Zighhi/Preamp-with-Tone-Control/P1_435B_Zglimbea_Andrei.pdf

Universitatea POLITEHNICA
București Facultatea E.T.T.I. Anul universitar 2022-2023

# PROIECT 1

## Proiectarea și realizarea unui preamplificator audio cu corectie de ton

N = 2

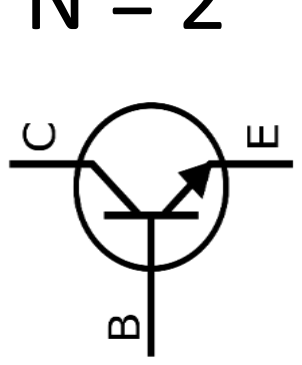
[picture p1: figure]

Coordonator științific: | Zglimbea Andrei
Prof. dr. ing. Dragoș Dobrescu | Grupa 435 B

## CUPRINS

2.Date initiale de

3.Simulari |
4.Asamblare |

5.Manual de

6.Bibliografia |

## 1.INTRODUCERE

### 1.1 Amplificatorul audio

Un amplificator audio este utilizat pentru a creste amplitudinea unei forme de undă a semnalului,fără a modifica alți parametrii ai formei de undă,cum ar fi frecventa sau forma de undă.Ele sunt unul dintre cele mai frecvent utilizate circuite in electronică și îndeplinesc o varietate de funcții într-un număr mare de sisteme electronica.

Amplificatoarele de tensiune audio sunt folosite pentru a amplifica semnalele de nivel scăzut de la microfoane,pickup-uri de bandă si disc.Cu circuite suplimentare,ele indeplinesc funcții precum corecția tonului,egalizarea nivelurilor de semnal si mixarea de la diferite intrări,in general au caștig de tensiune ridicat ,si mediu pana la rezistena ridicata de iesire.

Rolul unui amplificator audio este: de a mari semnalul sonor de intrare,de a reda un volum mai puternic.Iar aceste lucruri sunt posibile prin intermediul sistemului de boxe conectat la sursa de amplificare.Semnalul audio preluat de amplificator din dispozitive de receptie,precum instrumentele muzicale,laptopurile,casetofoanele, este de slaba putere.Circuitul de iesire din componenta amplificatorului este cel care,dupa ce preia acest semnal slab,genereaza unul nou,mai puternic de aceasta data,care ajunge ulterior sa fie redat prin intermediul boxelor.Boxele sunt un element intermediar al sunetului,reusind sa ofere acea calitate despre care vorbim.

### 1.2 Corectorul de ton de tip Baxandall

Circuitul de control al tonului Baxandall este un circuit analogic care asigura controlul independent al frecventelor joase si inalte,atat bass,cat si treble pot fi amplificate sau atenuate ,iar cu ambii parametrii in pozitiile lor medii,ofera un raspund de frecventa relativ plat.

In amplificatoarele hi-fi,controlul tonului se refera la cresterea sau reducerea anumitor frecvente audio,Aceste lucru se poate face pentru a se potrivi preferintelor ascultatorului,nu toata lumea percepe sunetul exact in acelasi mod,de exemplu raspunsul in frecventa al urecii umane se modifica odata cu varsta.Camera sau sala in care este reprodus sunetul va afecta,de asemenea,natura sunetului.Multe tehnici sunt folosite pentru a modifica sunetul,si in special raspunsul in frecventa al amplificatoarelor care produc sunetul.Acestea variaza de la simple filtre RC,la retele de control al frecventei pasive si active pana la procesarea complexa a semnalului digital.

## 2.DATE INITIALE DE PROIECTARE

### 2.1 Descrierea proiectului

Să se proiecteze şi să se realizeze practic un preamplificator de audiofrecvență cu corecție de ton având următoarele caracteristici:

- Tensiunea de alimentare unipolară (VCC=12 Volți) sau bipolară (VCC=12 , VEE=-VCC). Semnalizarea prezenței tensiunii cu LED.
- Tensiune de intrare alternativă cu amplitudinea 10 mV.
- Banda de frecvență cuprinsă între fj=200 Hz și fs=6 kHz.
- Frecvența centrală neutră la corecția de ton 2 kHz.
- Corecție de ton de tip BAXANDALL sau echivalentă cu +- (12) dB.
- Amplificarea în tensiune la frecvența neutră 100, echivalentă 40 dB.
- Rezistența de ieșire pentru a utiliza rezistența de sarcină a unor căști de 600 Ohmi.

### 2.2 Schema bloc a montajului electric

Montajul este compus din 4 etaje de amplificare,respectiv unul de intrare si trei de iesire,cuplate prin intermediul retelei de reactie de tip RC.

### 2.3 Schema de principiu propusa a amplificatorului

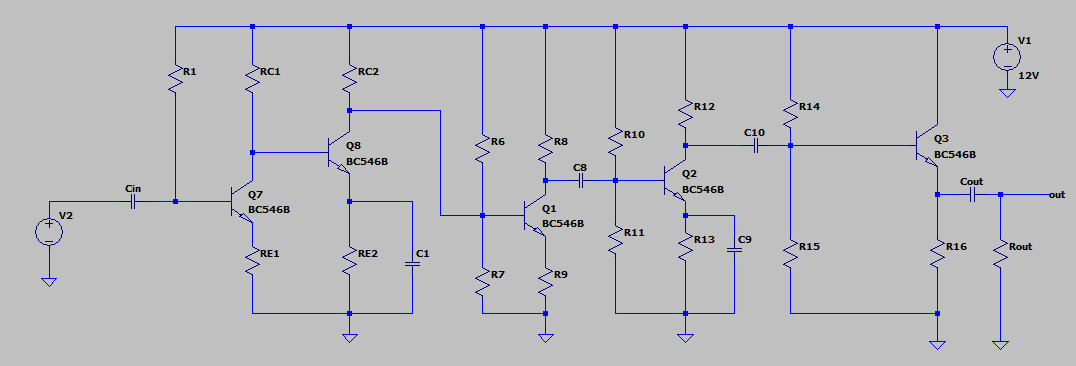
[picture p2: figure]

Amplificatorul este compus din 4 etaje de amplificare:

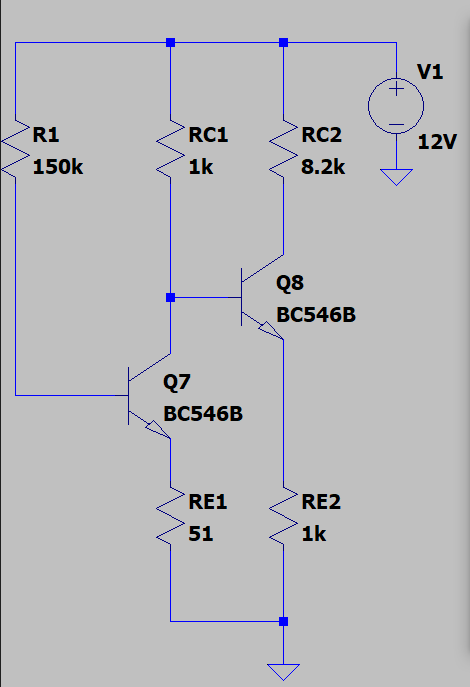
[picture p3: figure]

Etajul de intrare:

Acesta are rolul de combate atenuarea introdusa de corectorul de ton,astfel avand un castig de aproximativ 20 dB.

Etajele de amplificare:

Cel de al doilea si al treilea etaj rolul de a amplifica semnalul

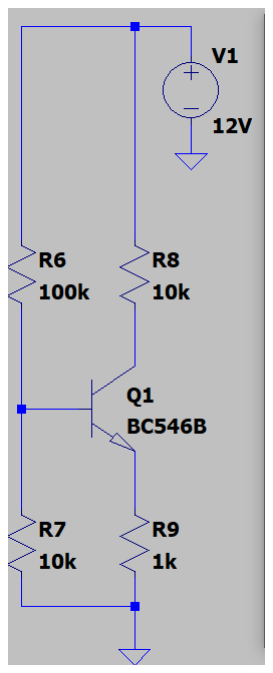
[picture p4: figure]
Aceste doua
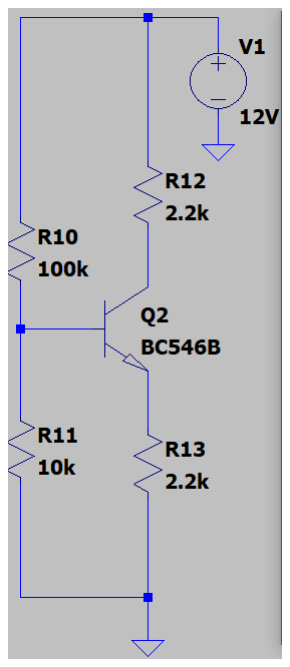
[picture p5: figure]

audio | cu 40 dB,acestea fiind in configuratia emitor comun.Acest tip de
| etaj introduce un defazaj de 90° , astfel prin folosirea a doua astfel
| de etaje semnalul de la iesire va fii in faza cu cel de la intrare.

Etajul de iesire:

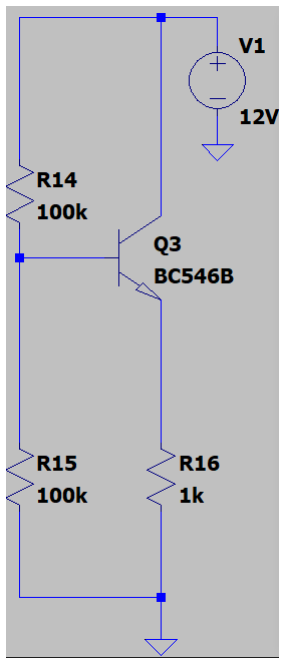
[picture p6: figure]

Etajul de iesire este un colector comun , si acesta are rolul de a mentine amplificarea constanta la 40 dB indiferent de care este sarcina acestui preamplificator.

### 2.4 Corectorul de ton de tip Baxandall

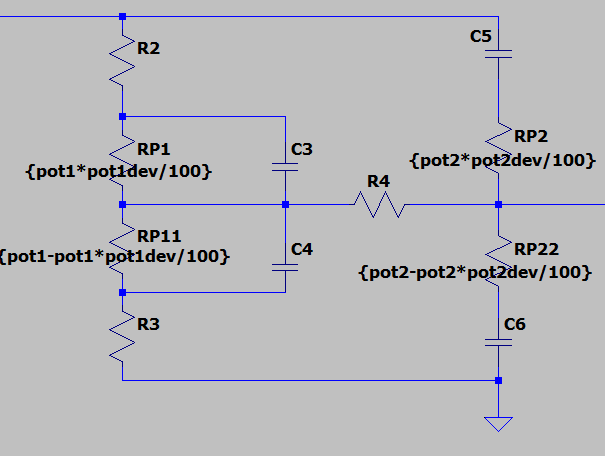
[picture p7: figure]

### 2.5 Dimensionarea componentelor corectorului de ton

RP1 se afla la maxim , deci amplifica frecventele joase fj = 200 Hz.

R2 , C4 formeaza un FTJ ft = 1/2π R2C4 , rezulta R2 = 15 kΩ si C4 = 10 nF.

RP1 la minim , deci atenueaza frecventele joase fj = 200 Hz.

R3 , C3 formeaza un FTS ft = 1/2π R3C3 , rezulta R3 = 1.5 kΩ si C3 = 1 nF.

RP2 la maxim , deci amplifica frecventele inalte fs =6 kHz.

RP2 la maxim , deci atenueaza frecventele inalte fs =6 kHz.

R4 , C6 formeaza un FTJ ft = 1/2π R4C6 , rezulta R4 = 22 kΩ si C6 = 4.7 nF

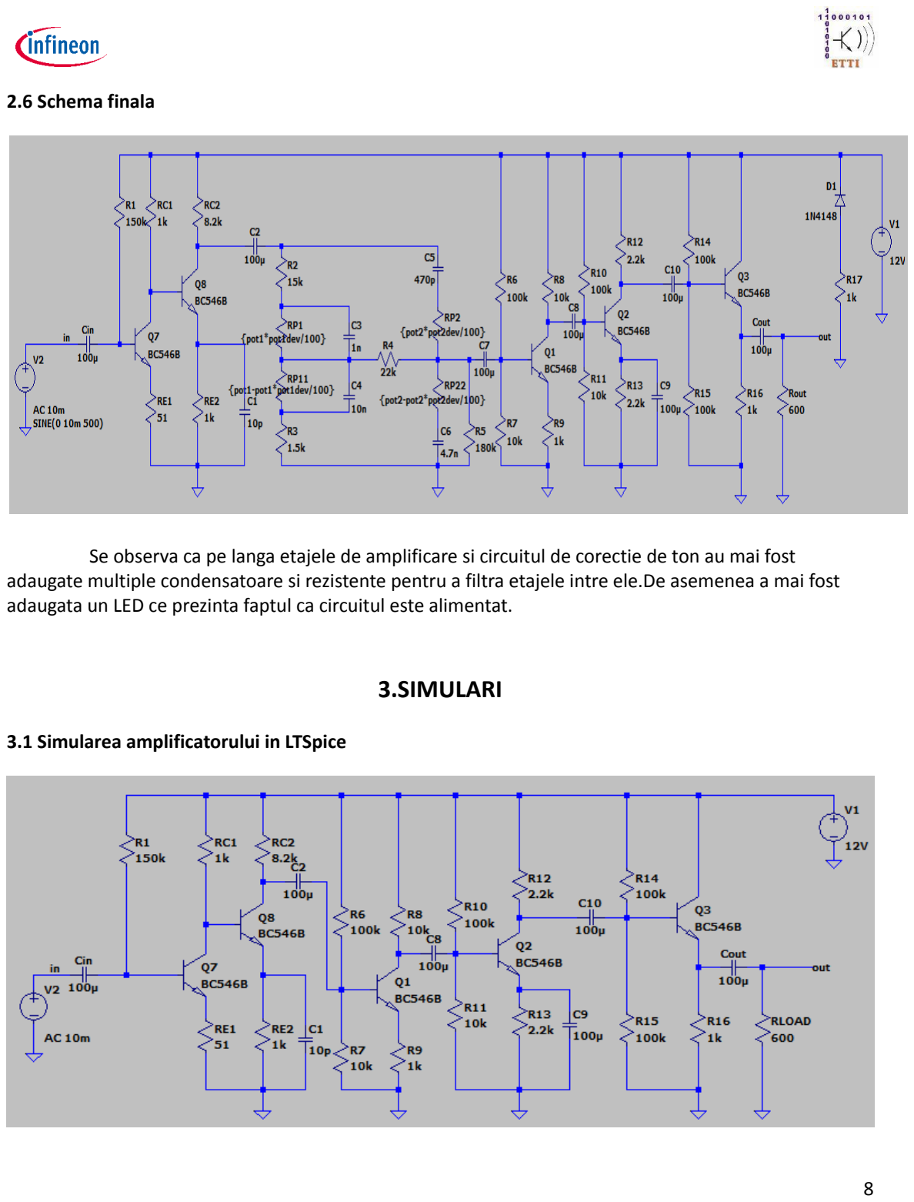
[picture p8: page 8]

### 2.6 Schema finala

Se observa ca pe langa etajele de amplificare si circuitul de corectie de ton au mai fost adaugate multiple condensatoare si rezistente pentru a filtra etajele intre ele.De asemenea a mai fost adaugata un LED ce prezinta faptul ca circuitul este alimentat.

### 3.SIMULARI

### 3.1 Simularea amplificatorului in LTSpice

a)Simularea in frecventa

Vom realiza o simulare in a.c.pana la 20 kHz pentru a vedea raspunsul amplificatorului in frecventa in spectrul audio,acesta fiind cel de interes.

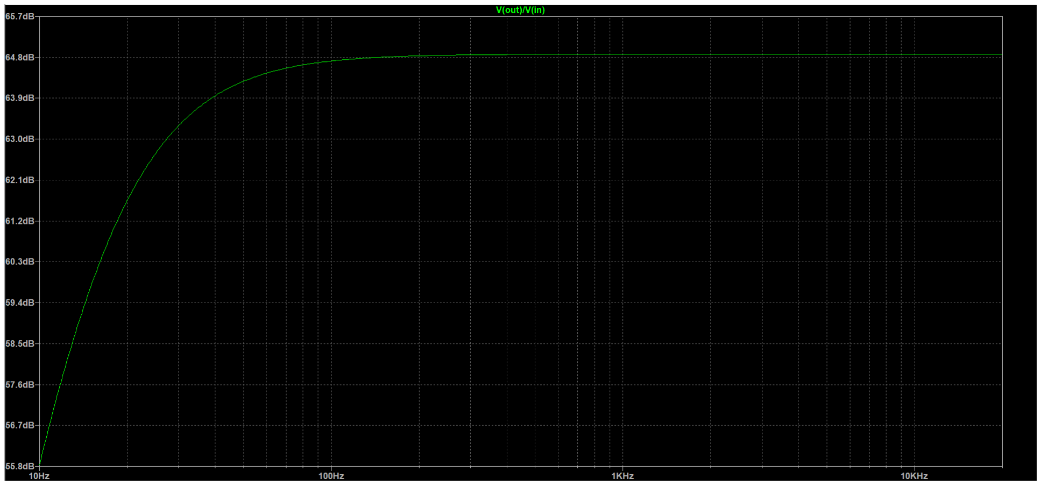
[picture p9: figure]

nr.simularea in frecventa a amplificatorului

Se observa ca amplificatorul are un castig de 65 dB , pentru ca la iesirea intregului circuit sa obtinem un castig de aproximatov 40 dB , la frecventa neutra de 2 kHz , acesta trebuie sa compenseze atenuarea de aproximativ 20 dB introdusa de circuitul de corectie de ton,acesta fiind pasiv.

b)Simularea punctului static de functionare

Vom simula punctul static de functionare in LTSpice si il vom compara cu valorile rezultate din calcule,ce vor fii facute pentru fiecare etaj de amplificare in parte.

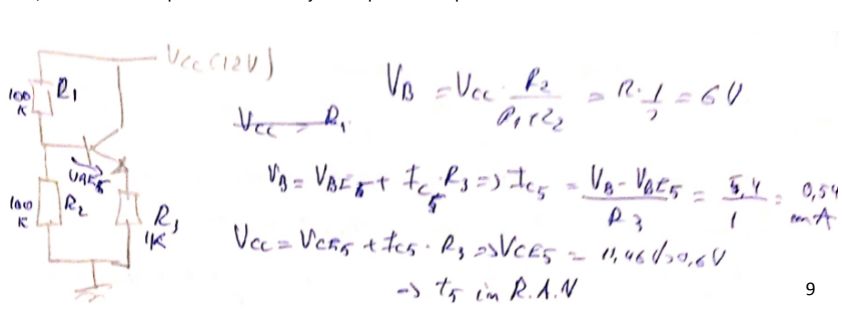
[picture p10: figure]

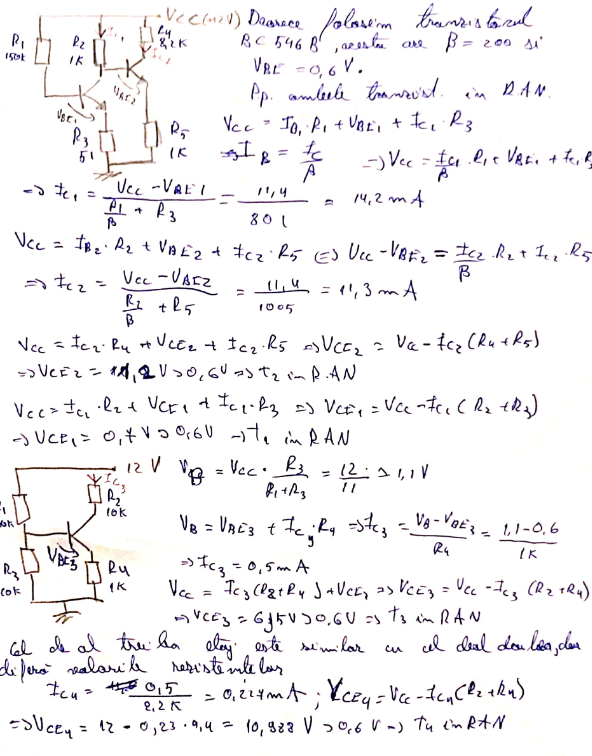
[picture p11: figure]

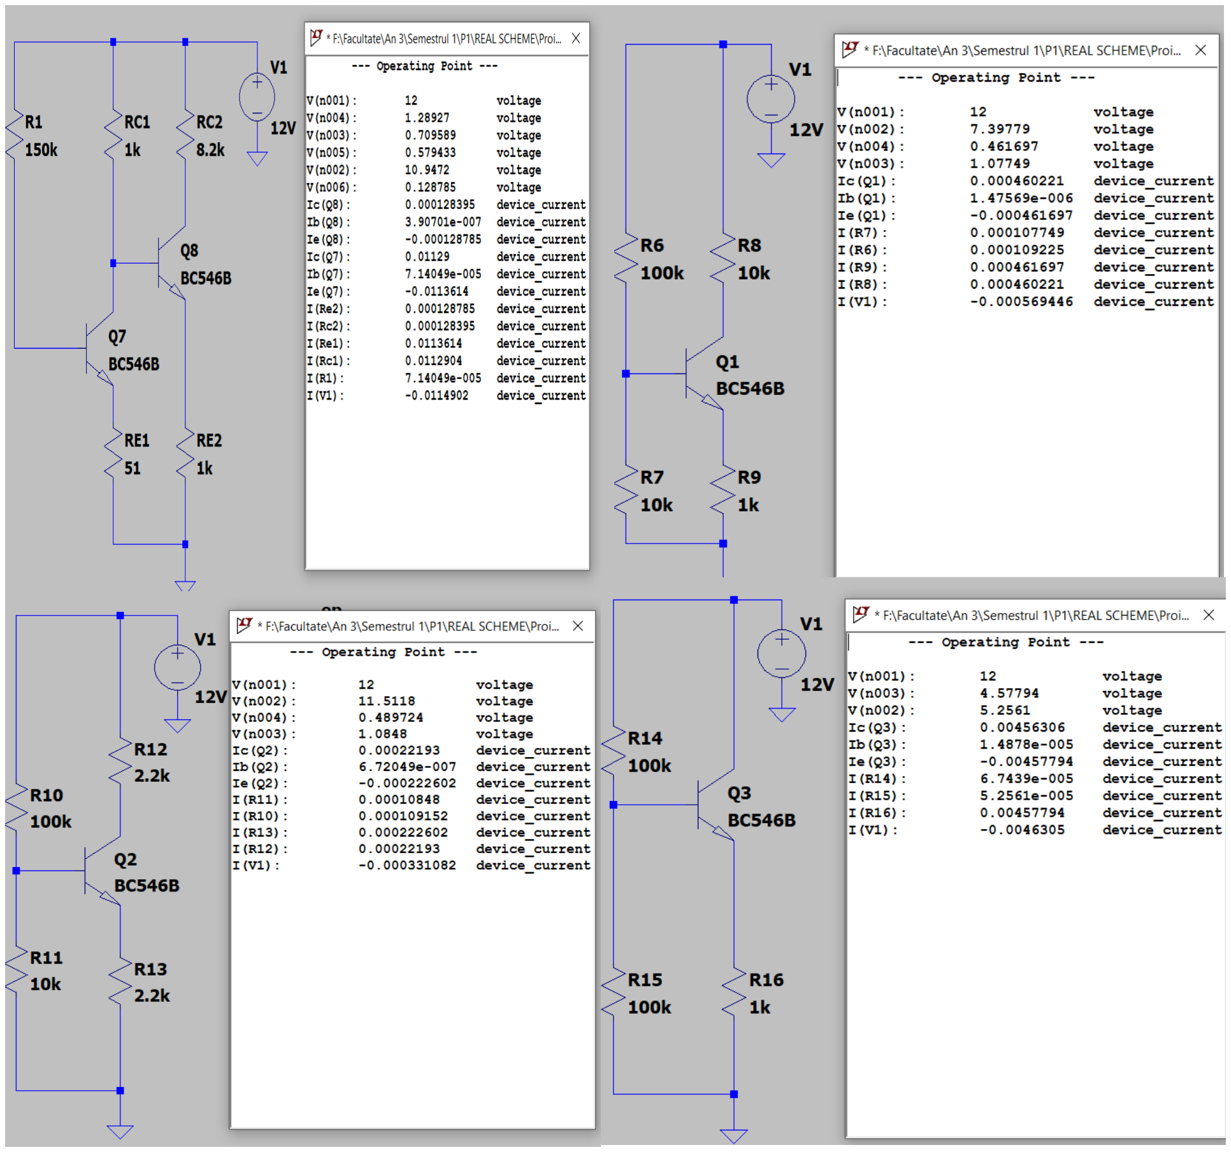
[picture p12: figure]

Se observa ca rezultatele calculate sunt aproximativ egale cu cele simulate.

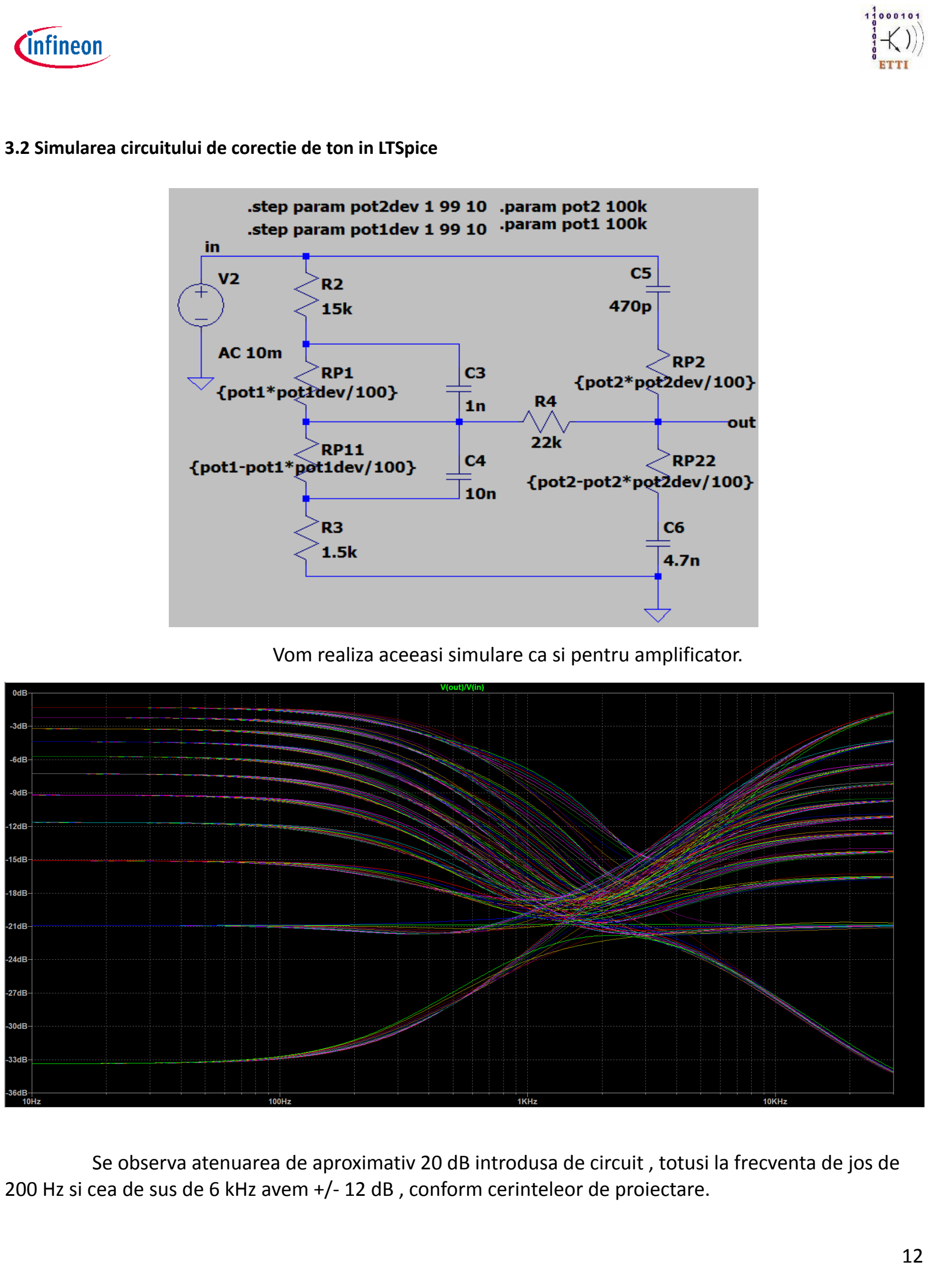
[picture p13: page 12]

### 3.2 Simularea circuitului de corectie de ton in LTSpice

Vom realiza aceeasi simulare ca si pentru amplificator.

Se observa atenuarea de aproximativ 20 dB introdusa de circuit , totusi la frecventa de jos de 200 Hz si cea de sus de 6 kHz avem +/- 12 dB , conform cerinteleor de proiectare.

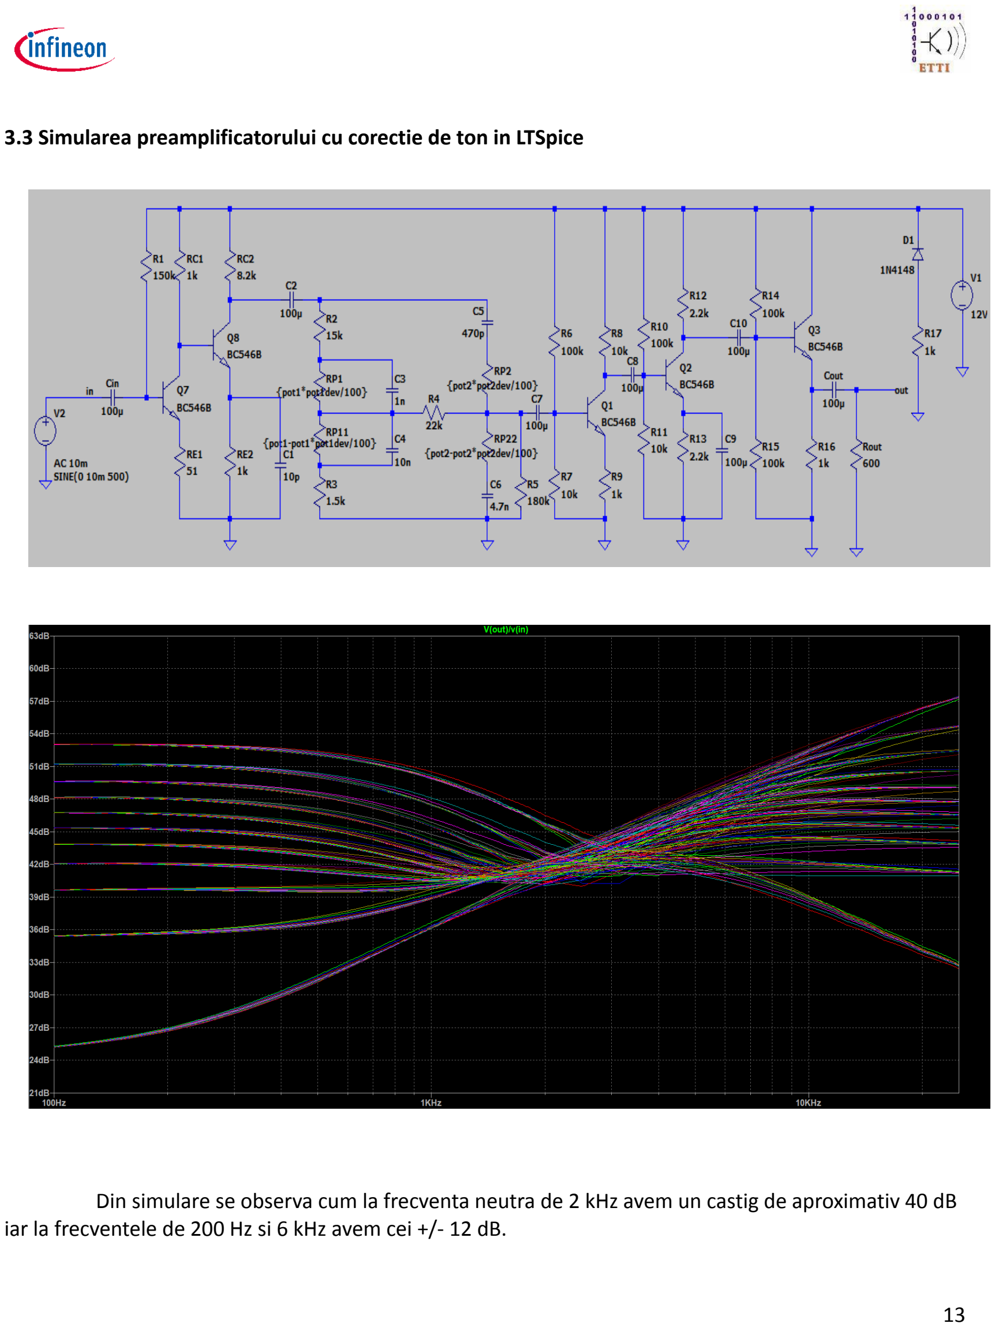
[picture p14: page 13]

### 3.3 Simularea preamplificatorului cu corectie de ton in LTSpice

Din simulare se observa cum la frecventa neutra de 2 kHz avem un castig de aproximativ 40 dB iar la frecventele de 200 Hz si 6 kHz avem cei +/- 12 dB.

## 4. ASAMBLARE

### 4.1 Raport de post-procesare - Bill of materials (BOM)

Deoarece circutiul a fost proiectat cu gandul de a fii realizat in THT , valorile componentelor sunt alese astfel incat sa nu trebuiasca sa se construiasca componente de valori specifice din
componente cu valori reale.Astfel in circuit sunt prezente doar valori de componente ce se gasesc in THT.

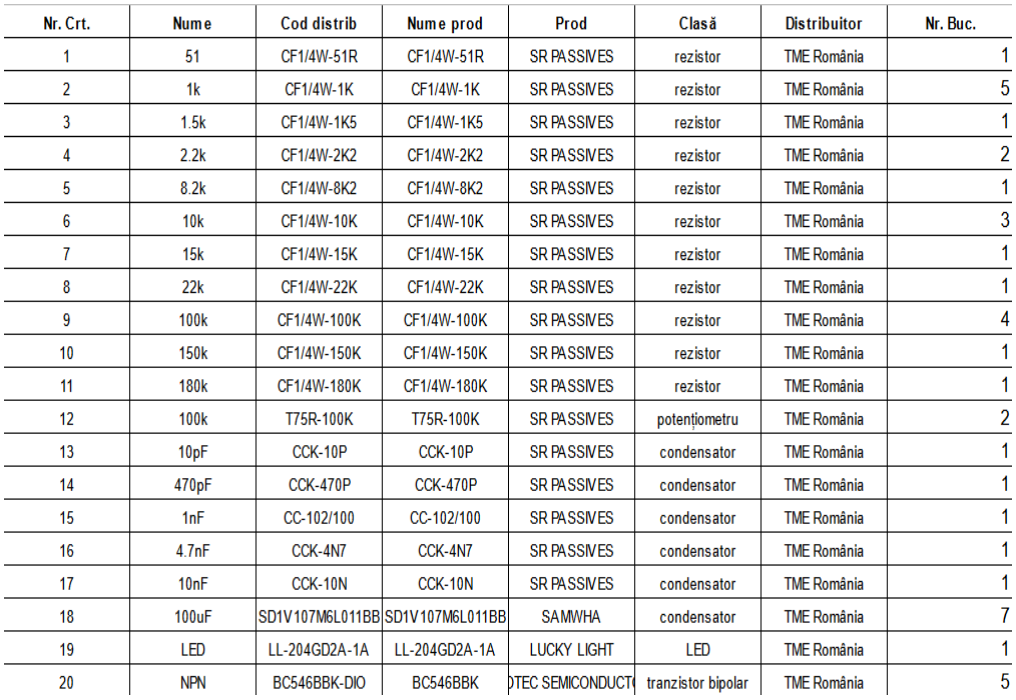
[picture p15: figure]

### 4.2 Plan de plantare pe perfo-board

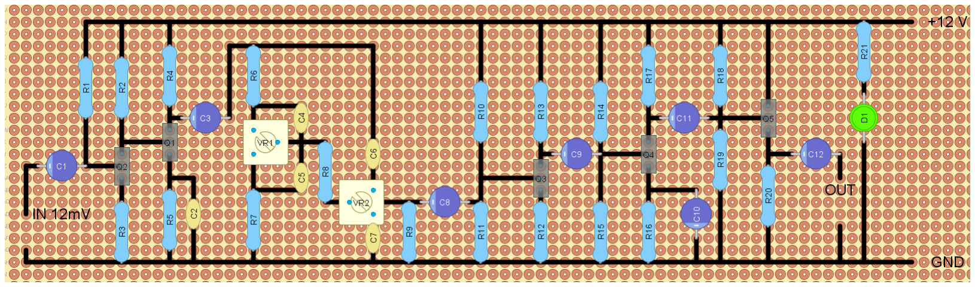
[picture p16: figure]

### 4.3 Mod de realizare

În asamblarea convențională THT, componentele cu fir sau prin inserție (denumite și componente THT) sunt plasate în găuri perforate în PCB-uri, care sunt apoi fixate pe plăcuțele de contact folosind diferite tehnici de lipire. Aceste componente diferă de componentele montate pe suprafață (SMT) deoarece au fire care le conectează "prin" găurile din plăci, mai degrabă decât așezându-le pe pastă de lipit de pe suprafața unui PCB.
Chiar dacă metodele de asamblare SMT au înlocuit în mare parte procesul de asamblare
convențional mai scump, ce necesită o muncă mai
intensă, există încă multe utilizări pentru THT în piața

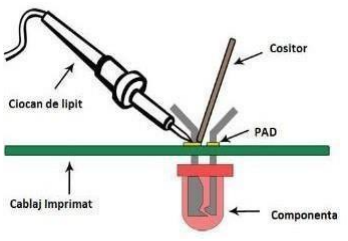
[picture p17: figure]

de producție de electronice din ziua de azi, inclusiv electronice de înaltă performanță
(rezistoare / relee de înaltă tensiune), componente cu solicitări mecanice ridicate (conector,întrerupătoare) și componente mari (de exemplu condensatoare, inductoare). După ce componentele THT sunt așezate manual pe plăci, există în general trei tehnici diferite de lipire care sunt utilizate:

Lipirea în Val

Cu lipirea în val, componentele sunt lipite pe plăci în trei etape. Mai întâi, fluxul de spumă este aplicat uniform pe partea inferioară a perfo-board-ului, astfel încât este acoperit în întregime. Apoi, materialul de flux este activat cu o unitate preîncălzită și încălzit până la temperatura de lipire. În procesul de lipire convențional, plăcile sunt apoi deplasate printr-un val de lipit turbulent. Aliajul de lipire se atașează la pinii componentelor din orificiile de contact. După o perioadă de răcire, aliajul se întărește și fixează permanent componenta pe placă. În timpul etapei finale, plăcile sunt răcite și deplasate într-o baie de spălare, unde materialul de flux rămas este curățat.

Lipirea Manuală

Ori de câte ori lipirea în val nu este posibilă, se utilizează asamblarea manuală. Asamblarea manuală este realizată de tehnicienii cu o mare experiență, care sunt instruiți folosind standardele MIL.

Lipirea Selectivă

Pentru comenzile de producție în serie, lipirea selectivă permite componentelor THT să fie plasate pe plăci care altfel nu ar fi eligibile pentru lipirea în val. În astfel de cazuri, recurgem la procese de lipire selectivă, parțial sau total automatizate, atunci când trebuie aplicată o cantitate predeterminată de cositor sau dacă o anumită zonă a plăcii trebuie să fie păstrată fără material de flux. Aceste tipuri de cerințe de producție sunt tipice pentru clienții din industria auto.

## 5. MANUAL DE UTILIZARE

Preamplificatorul a fost proiectat pentru a funcționa optim la tensiunea de alimentare de 11V. Tensiunea de intrare se recomandă a avea valoarea de 10 mV.
- Se vor conecta bornele – la borna GND
- Tensiunea de IN se va conecta la borna VIN (borna +, 10 mV)
- Tensiunea de iesire se va conecta la borna VOUT
- A nu se atinge componentele sau conexiunile in timpul funcționarii
- A se manevra ținandu-se de marginile placii de asamblare
- A nu se folosi în afara intervalului de temperatură de (-30°C, 75°C)
- Nu se recomandă schimbarea componentelor circuitului, în acest caz, comportamentul nu poate fi determinat
- A se feri de umezeală și expunerea îndelungată la razele soarelui
- A nu se lăsa la îndemâna copiilor, decât sub supravegherea unui adult

## 6. BIBLIOGRAFIE

- http://www.dce.pub.ro
- https://www.newmatik.com/ro/productie-electronice/asamblare-tht
- https://www.soundstil.ro/blog/cum-functioneaza-un-amplificator-audio-principii-de-b aza (https://www.soundstil.ro/blog/cum-functioneaza-un-amplificator-audio-principii-de-baza)
- https://www.steinstokholm.com/preamp-tech-docs.html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 (https://www.steinstokholm.com/preamp-tech-docs.html)
- https://learnabout-electronics.org/Amplifiers/amplifiers42.php
- Note de curs - Circuite electronice fundamentale, Dragoș Dobrescu
