Zighhi/Preamp-with-Tone-Control/AC_Sweep.png

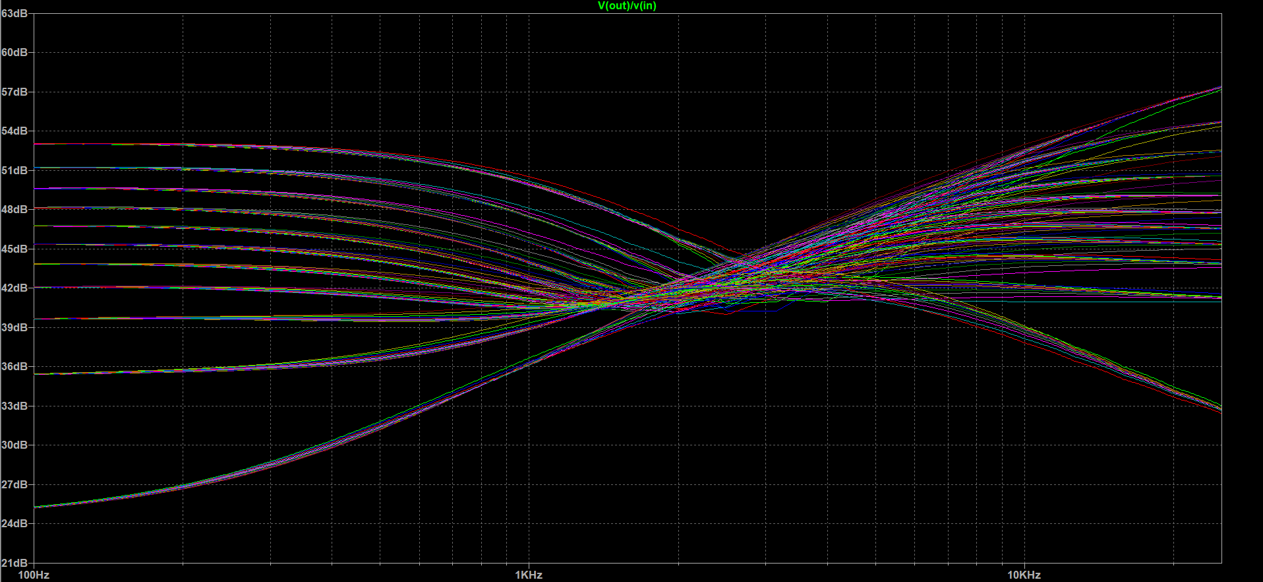
AC_Sweep.png
