Zighhi/Preamp-with-Tone-Control/THT Planting Plan.png

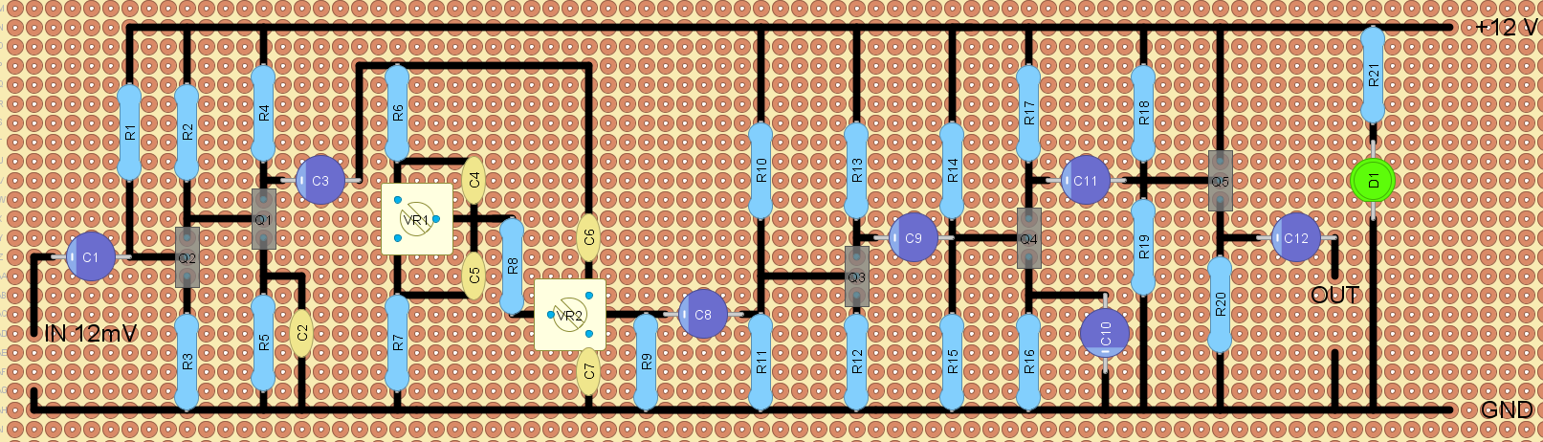
THT Planting Plan.png
