Zighhi/Preamp-with-Tone-Control/LTSpice project.asc

C1: cap; 10p
C2: cap; 100µ
C3: cap; 1n
C4: cap; 10n
C5: cap; 470p
C6: cap; 4.7n
C7: cap; 100µ
C8: cap; 100µ
C9: cap; 100µ
C10: cap; 100µ
Cin: cap; 100µ
Cout: cap; 100µ
D1: diode; 1N4148
Q1: npn; BC546B
Q2: npn; BC546B
Q3: npn; BC546B
Q7: npn; BC546B
Q8: npn; BC546B
R1: res; 150k
R2: res; 15k
R3: res; 1.5k
R4: res; 22k
R5: res; 180k
R6: res; 100k
R7: res; 10k
R8: res; 10k
R9: res; 1k
R10: res; 100k
R11: res; 10k
R12: res; 2.2k
R13: res; 2.2k
R14: res; 100k
R15: res; 100k
R16: res; 1k
R17: res; 1k
RC1: res; 1k
RC2: res; 8.2k
RE1: res; 51
RE2: res; 1k
Rout: res; 600
RP1: res; {pot1*pot1dev/100}
RP2: res; {pot2*pot2dev/100}
RP11: res; {pot1-pot1*pot1dev/100}
RP22: res; {pot2-pot2*pot2dev/100}
V1: voltage; 12V
V2: voltage; SINE(0 10m 500); AC 10m
Named nets: 0, in, out
.step param pot2dev 1 99 10
.step param pot1dev 1 99 10
.param pot2 100k
.param pot1 100k
.ac dec 100 10 30k
;tran 0.1
